jonasbystrom/ESP-Now-Sensor-system-with-WiFi/img/batlife_d1minipro_ds18b20_1200mah.png

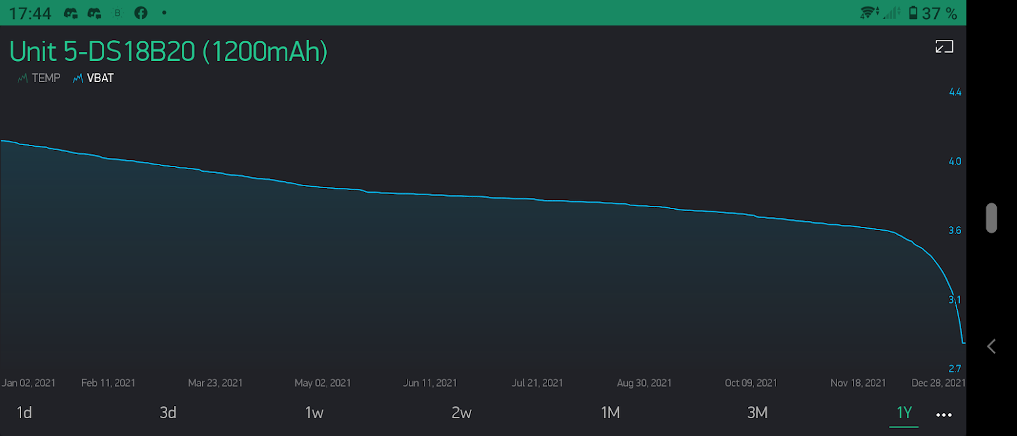
img/batlife_d1minipro_ds18b20_1200mah.png
