jonasbystrom/ESP-Now-Sensor-system-with-WiFi/img/batlife_d1minipro_sht30_45x45mm_solar_500mah.png

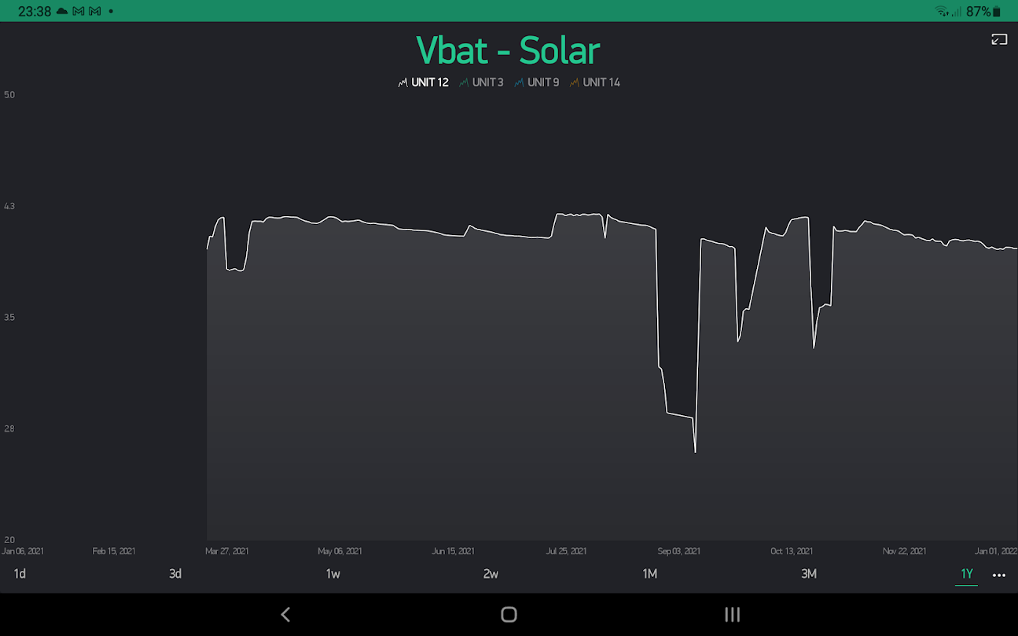
img/batlife_d1minipro_sht30_45x45mm_solar_500mah.png
