jonasbystrom/ESP-Now-Sensor-system-with-WiFi/img/batlife_d1minipro_sht30_2200mah.png

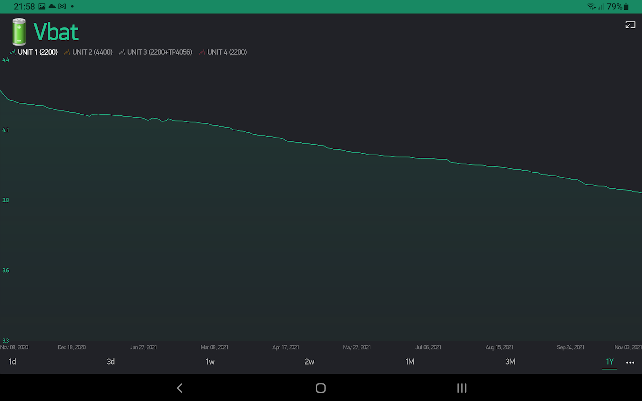
img/batlife_d1minipro_sht30_2200mah.png
